Grilled-Cheese-Engineering/micro-keyer/complete 1.jpg

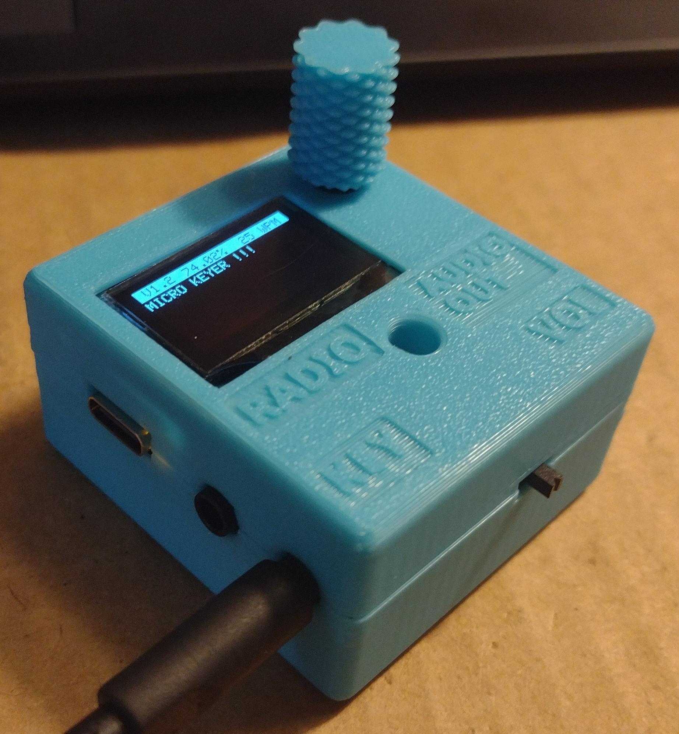
complete 1.jpg
