Grilled-Cheese-Engineering/micro-keyer/complete 2.jpg

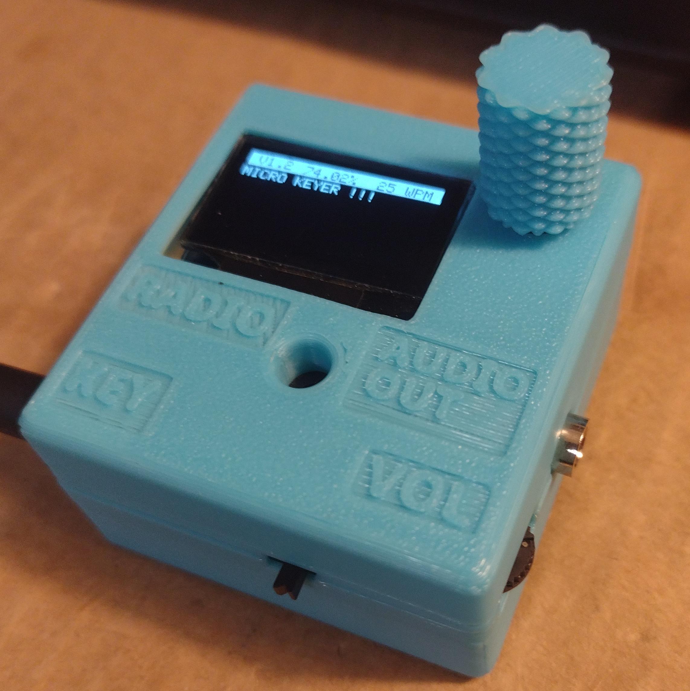
complete 2.jpg
