Grilled-Cheese-Engineering/micro-keyer/images/2026-10-27-21-33-01-062.jpg

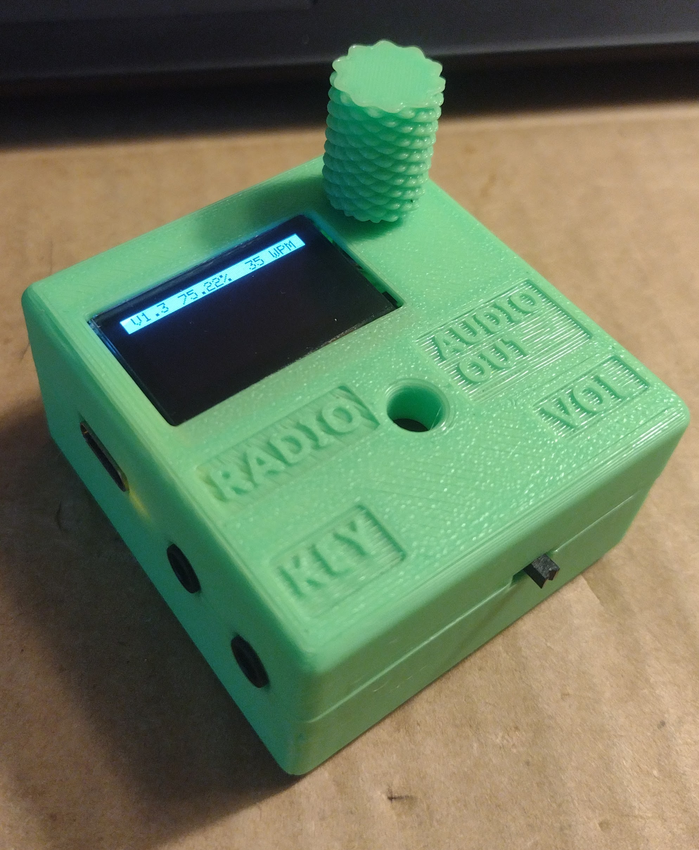
images/2026-10-27-21-33-01-062.jpg
