Grilled-Cheese-Engineering/micro-keyer/images/Screenshot_20261027_212848.png

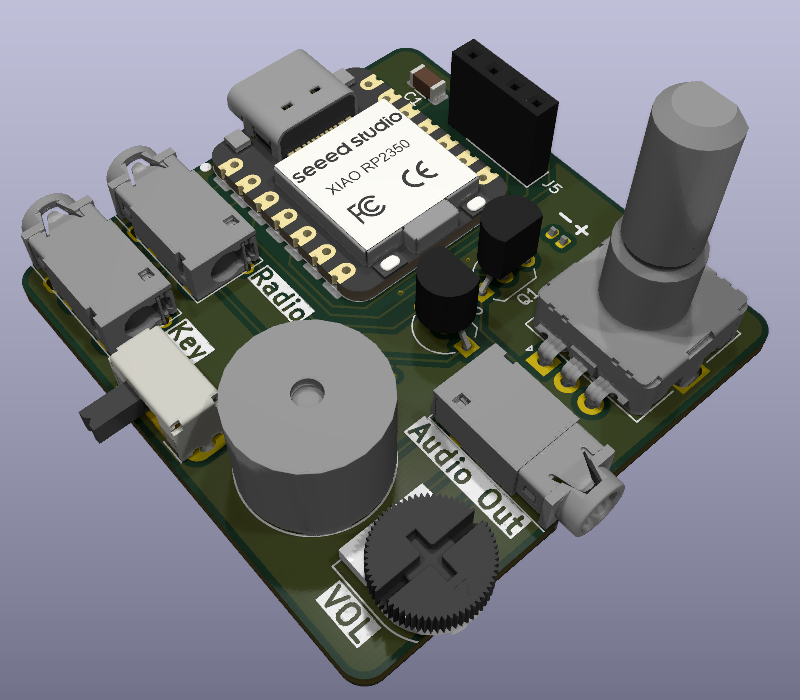
images/Screenshot_20261027_212848.png
