Grilled-Cheese-Engineering/micro-keyer/Screenshot_20260815_023649.png

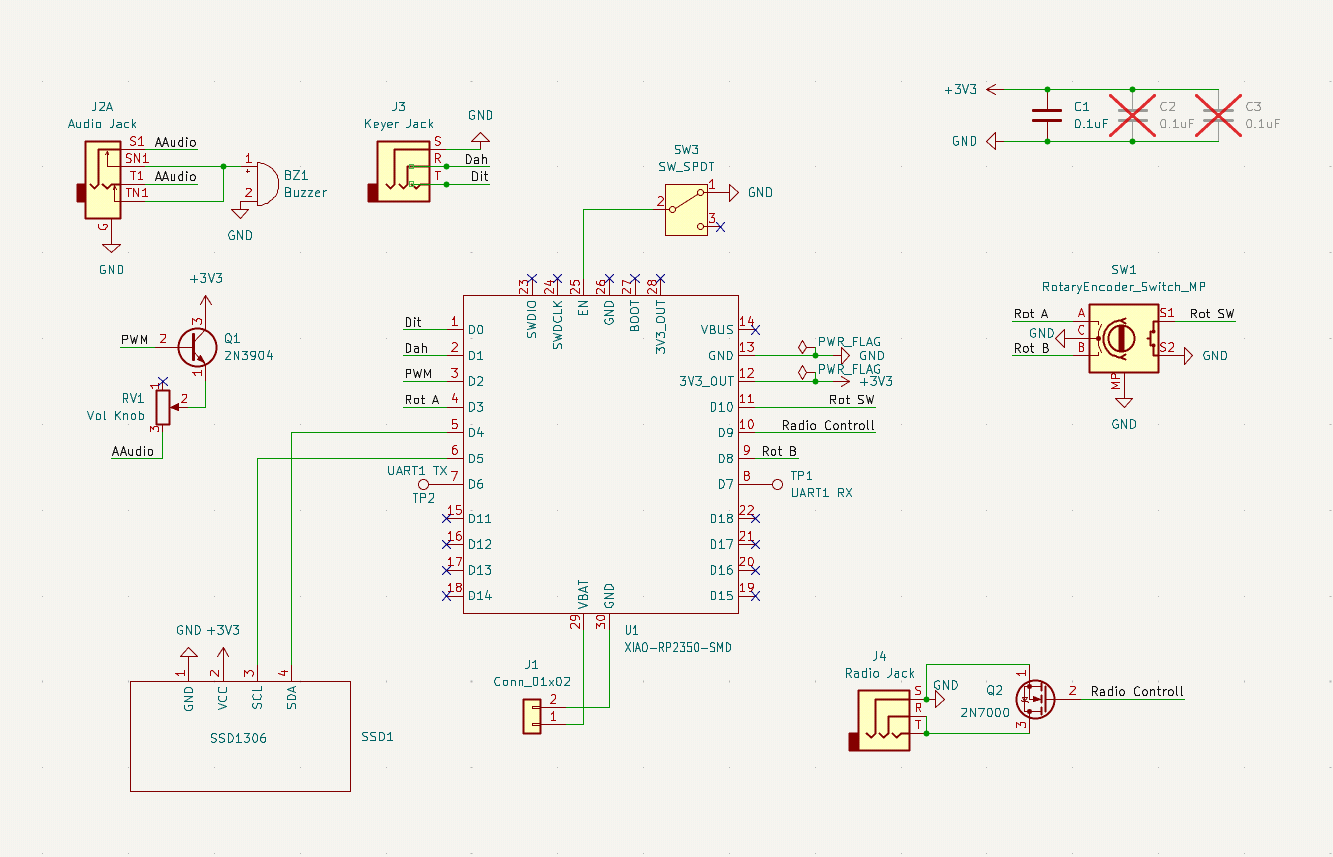
Screenshot_20260815_023649.png
