Grilled-Cheese-Engineering/micro-keyer/Screenshot_20260815_023707.png

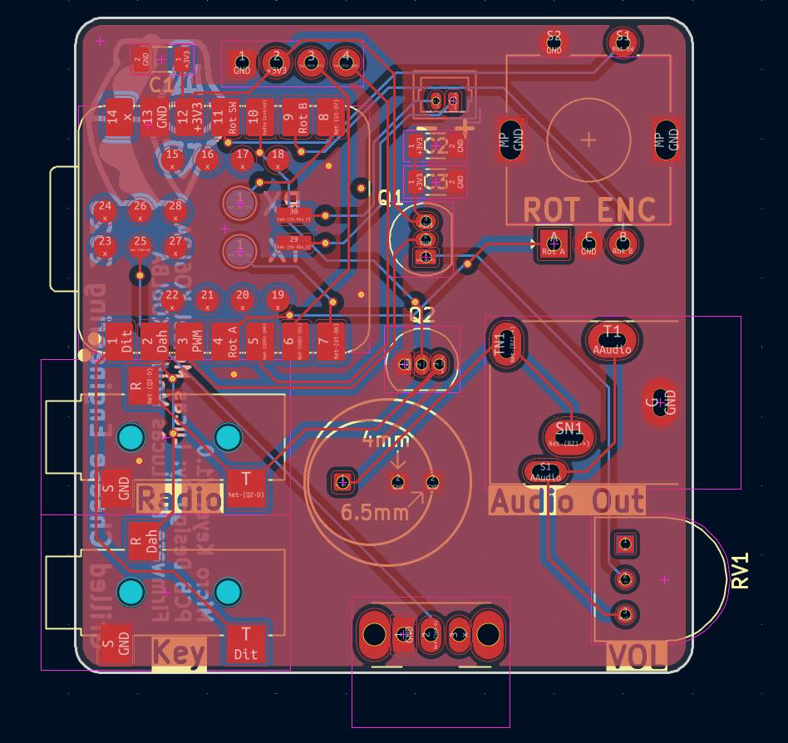
Screenshot_20260815_023707.png
