Grilled-Cheese-Engineering/micro-keyer/Screenshot_20260815_023733.png

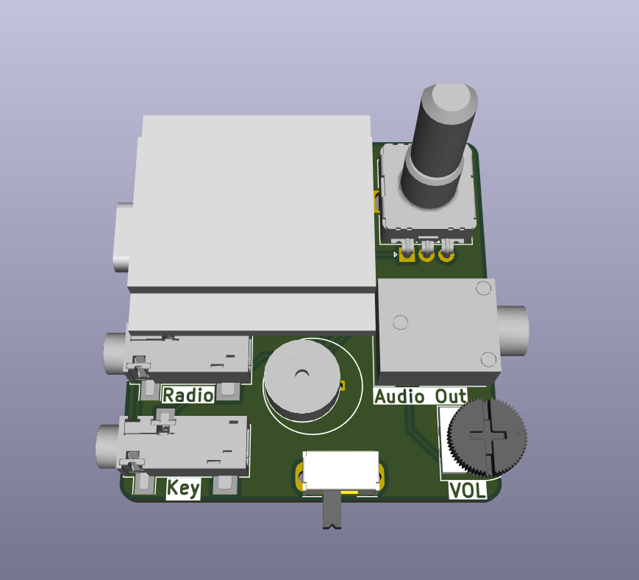
Screenshot_20260815_023733.png
