Grilled-Cheese-Engineering/micro-keyer/Screenshot_20260815_023755.png

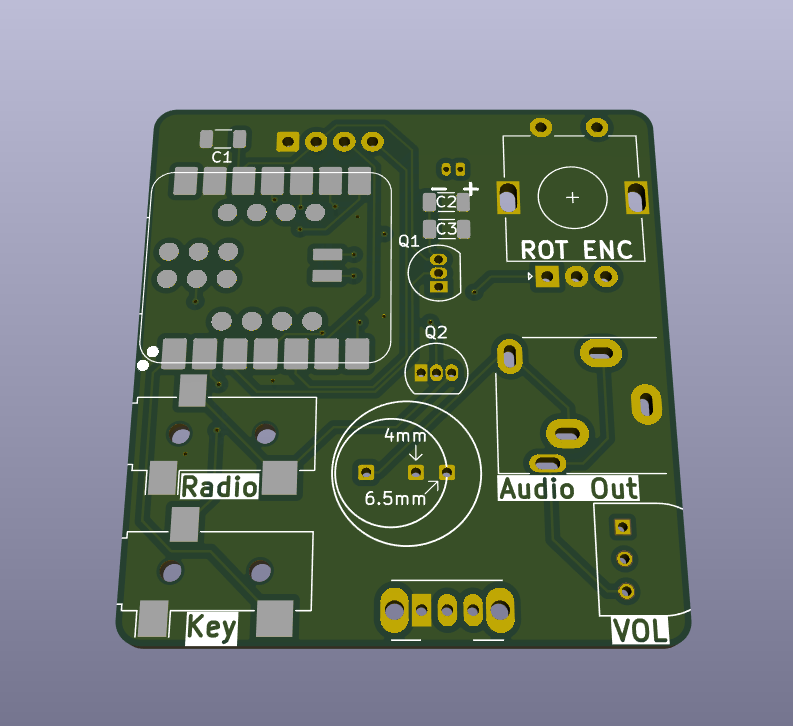
Screenshot_20260815_023755.png
