Grilled-Cheese-Engineering/micro-keyer/Screenshot_20260815_023818.png

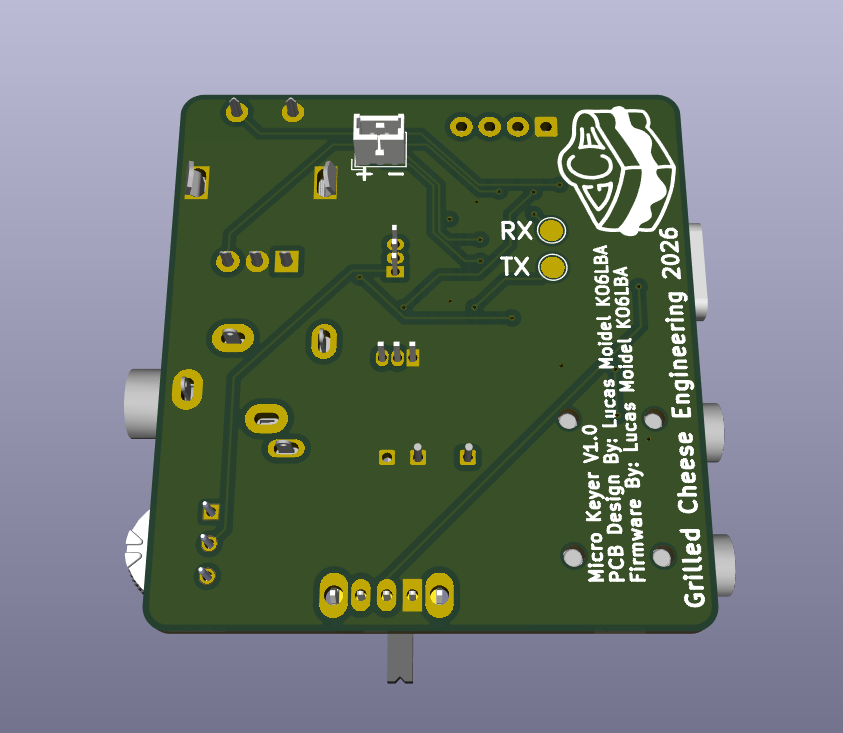
Screenshot_20260815_023818.png
