Grilled-Cheese-Engineering/micro-keyer/Screenshot_20260815_023836.png

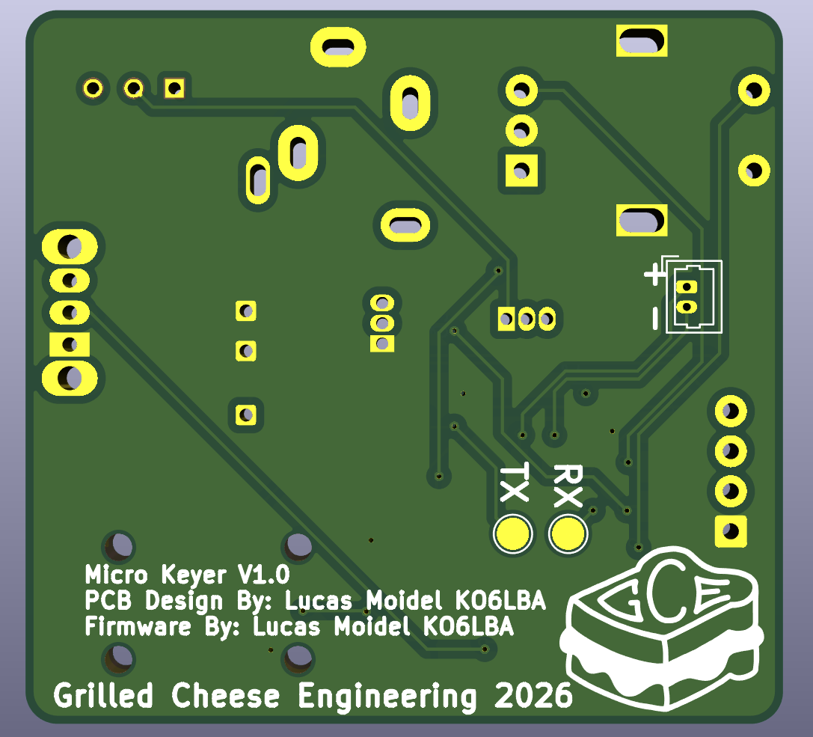
Screenshot_20260815_023836.png
