Grilled-Cheese-Engineering/micro-keyer/Screenshot_20260815_023911.png

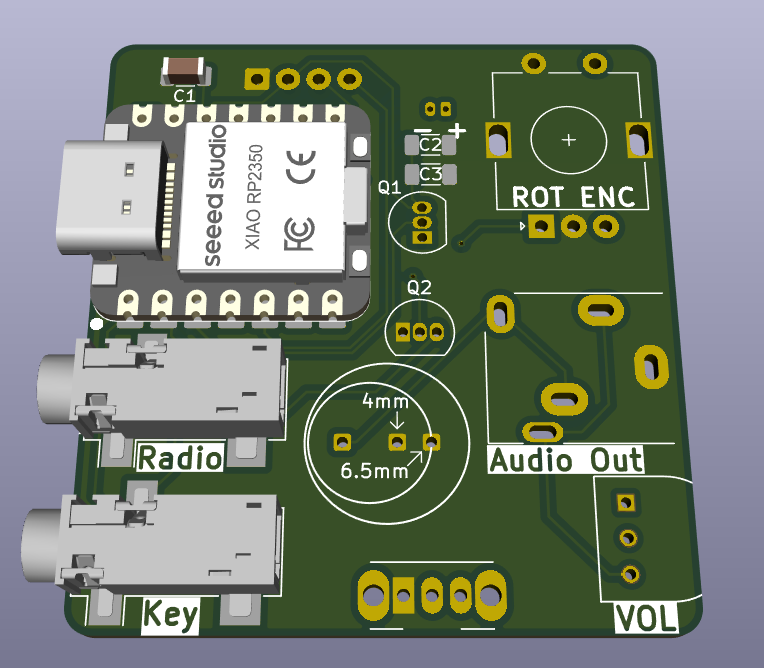
Screenshot_20260815_023911.png
