Grilled-Cheese-Engineering/micro-keyer/Screenshot_20260907_182525.png

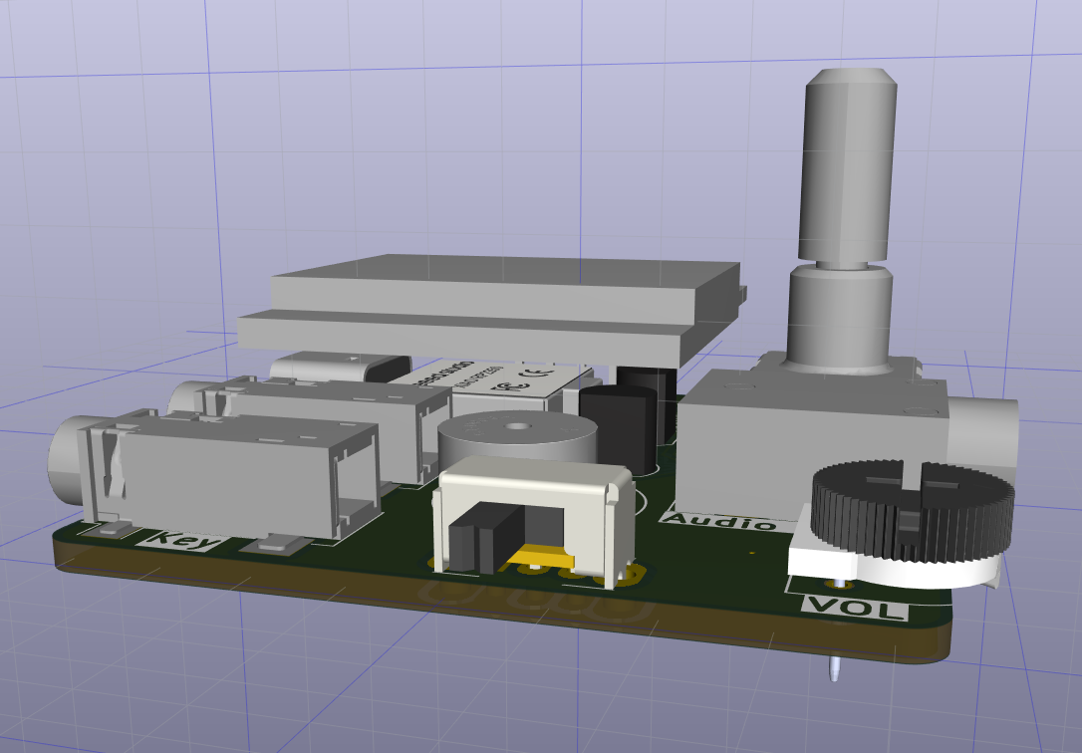
Screenshot_20260907_182525.png
