Grilled-Cheese-Engineering/micro-keyer/pcb/production/bom.csv

Designator | Footprint | Quantity | Value | LCSC Part #
BZ1 | buzzer_P4mm_9mm | 1 | Buzzer
C1 | 1206 | 1 | 0.1uF
J1 | Molex_PicoBlade_53047-0210_1x02_P1.25mm_Vertical | 1 | Conn_01x02
J2, J3, J4 | 54-00299 | 3 | Audio Jack
J5 | PinSocket_1x04_P2.54mm_Vertical | 1 | Conn_01x04_Socket
Q1 | TO-92_Inline_Wide | 1 | 2N3904
Q2 | TO-92_Inline_Wide | 1 | 2N7000
RV1 | TRIM_3352T-1-103LF | 1 | Vol Knob
SW1 | RotaryEncoder_Alps_EC11E-Switch_Vertical_H20mm | 1 | RotaryEncoder_Switch_MP
SW3 | SW_Slide_SPDT_Angled_CK_OS102011MA1Q | 1 | SW_SPDT
TP1 | TestPoint_Pad_D2.0mm | 1 | UART1 RX
TP2 | TestPoint_Pad_D2.0mm | 1 | UART1 TX
U1 | XIAO-RP2350-SMD-MODEL | 1 | XIAO-RP2350-SMD
