Grilled-Cheese-Engineering/micro-keyer/case.3mf

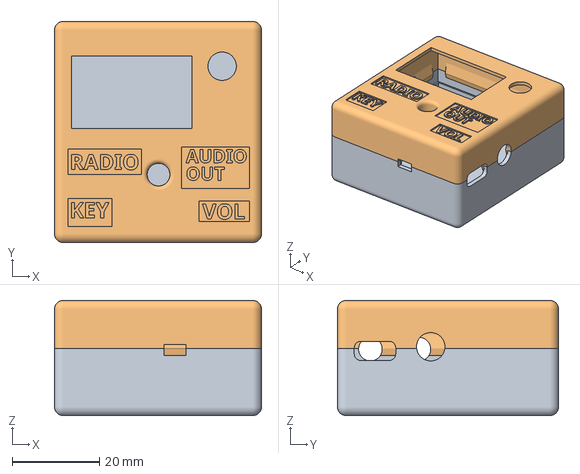
[picture p22: CAD file, 2026-11-06]
case.3mf
47.4 x 50.6 x 26.4 mm
