Grilled-Cheese-Engineering/micro-keyer/pcb/54-00174.STEP

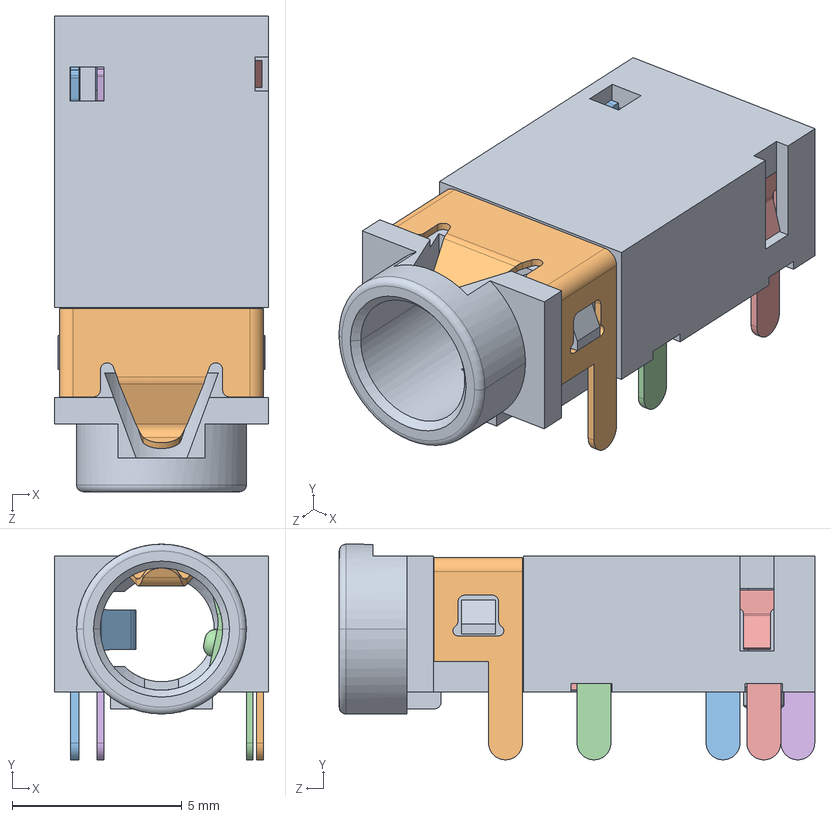
[picture p23: CAD file, 2026-10-26]
pcb/54-00174.STEP
6.30 x 6.35 x 14.0 mm
