Grilled-Cheese-Engineering/micro-keyer/knob.3mf

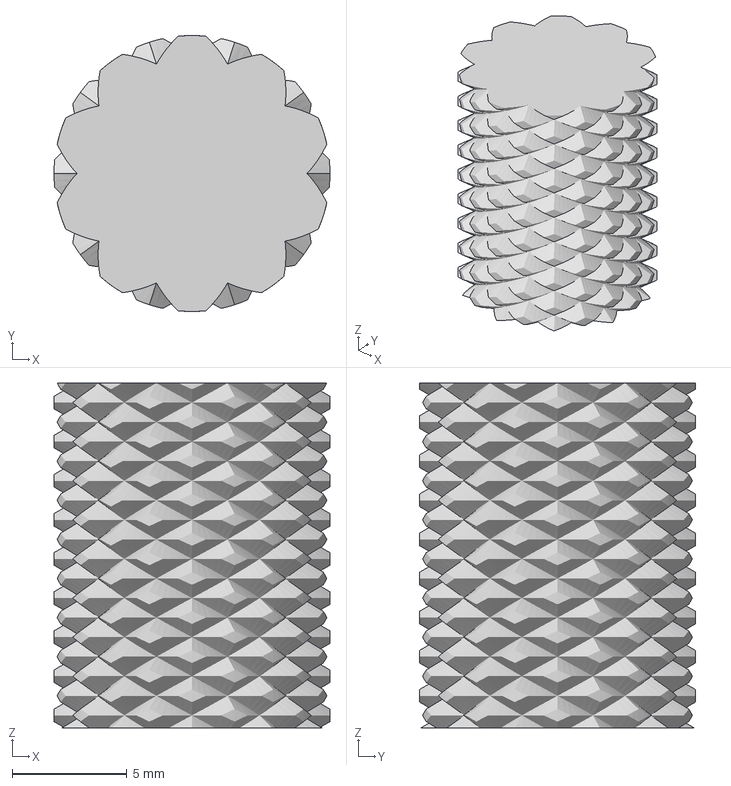
[picture p24: CAD file, 2026-09-29]
knob.3mf
12.0 x 12.0 x 15.0 mm
