Grilled-Cheese-Engineering/micro-keyer/pcb/WT-1205.step

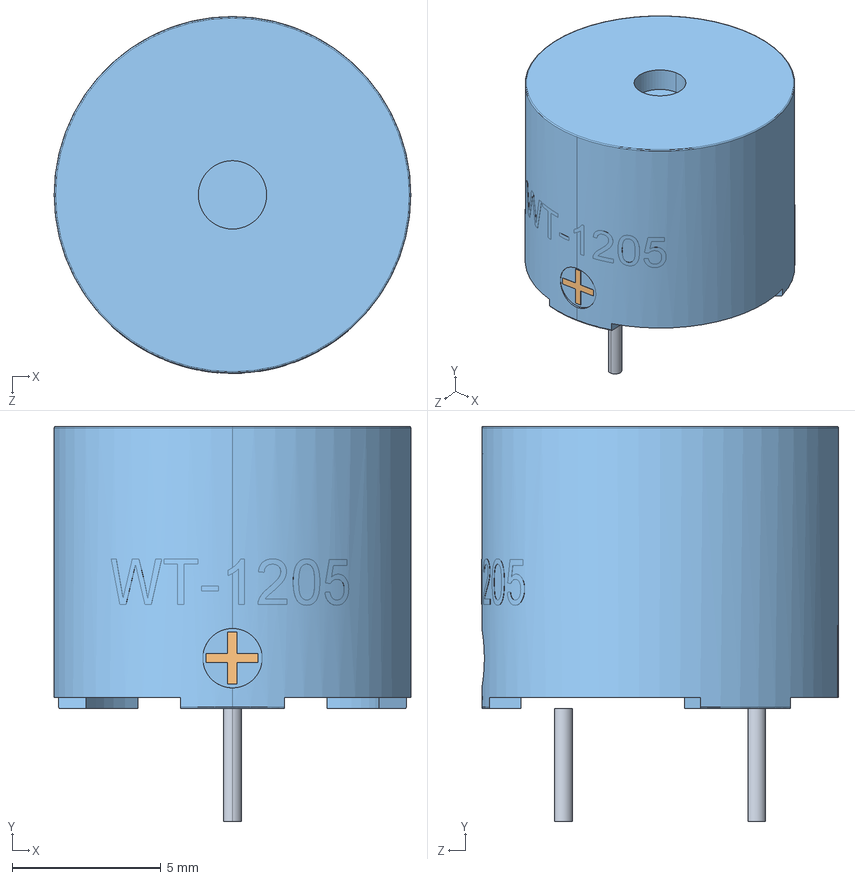
[picture p25: CAD file, 2026-10-26]
pcb/WT-1205.step
12.0 x 13.3 x 12.0 mm
