Grilled-Cheese-Engineering/micro-keyer/pcb/GT-0903A.step

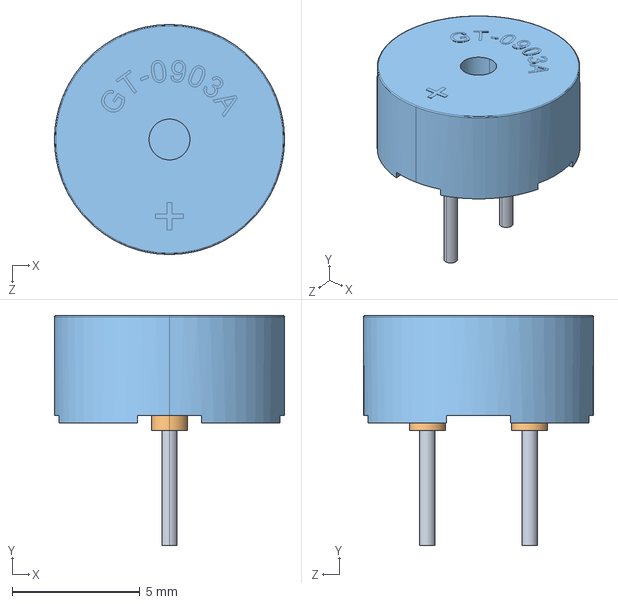
[picture p26: CAD file, 2026-08-10]
pcb/GT-0903A.step
9.00 x 9.01 x 9.00 mm
