Grilled-Cheese-Engineering/micro-keyer/pcb/PPPC041LFBN-RC.STEP

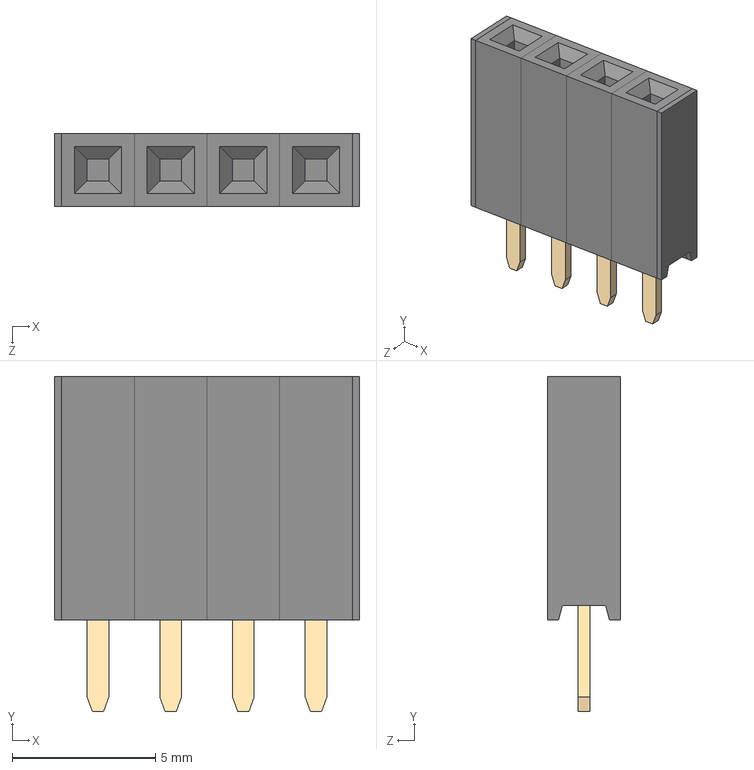
[picture p27: CAD file, 2026-08-10]
pcb/PPPC041LFBN-RC.STEP
10.7 x 11.7 x 2.54 mm
PPPC021LFBN-RC_C04
Pin - Gold x 4
