Grilled-Cheese-Engineering/micro-keyer/pcb/3352T-1-103LF.step

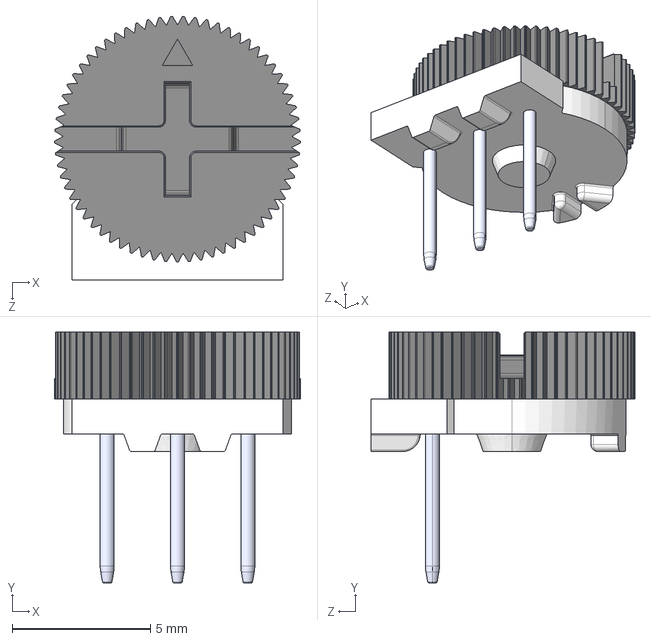
[picture p28: CAD file, 2026-08-09]
pcb/3352T-1-103LF.step
8.89 x 9.07 x 9.52 mm
