Grilled-Cheese-Engineering/micro-keyer/pcb/ec11e18244au.step

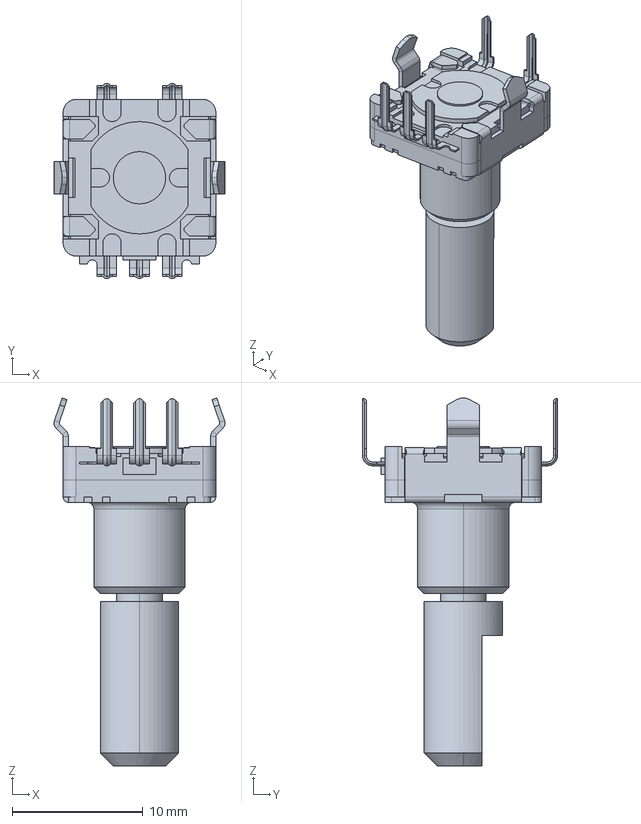
[picture p29: CAD file, 2026-08-09]
pcb/ec11e18244au.step
13.1 x 15.0 x 28.2 mm
