Grilled-Cheese-Engineering/micro-keyer/pcb/Same_Sky_SJ1-3535NG.step

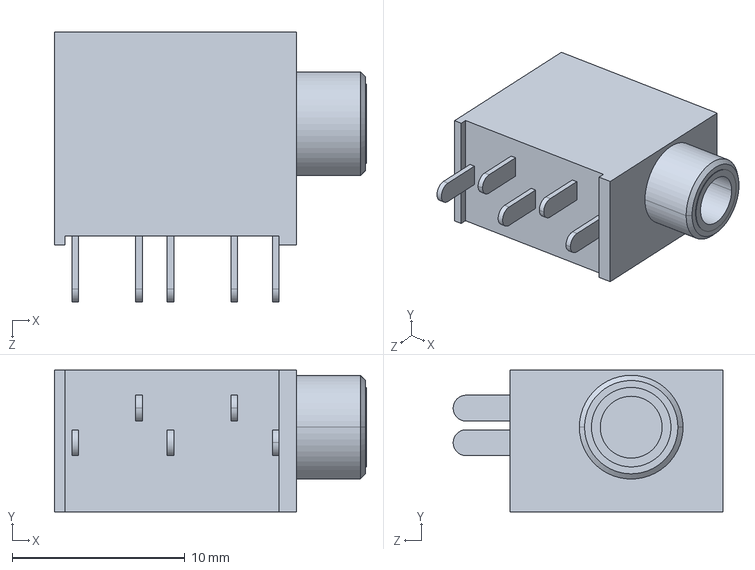
[picture p30: CAD file, 2026-08-09]
pcb/Same_Sky_SJ1-3535NG.step
18.1 x 8.20 x 15.6 mm
