Grilled-Cheese-Engineering/micro-keyer/pcb/Same_Sky_SJ-3523-SMT-TR.step

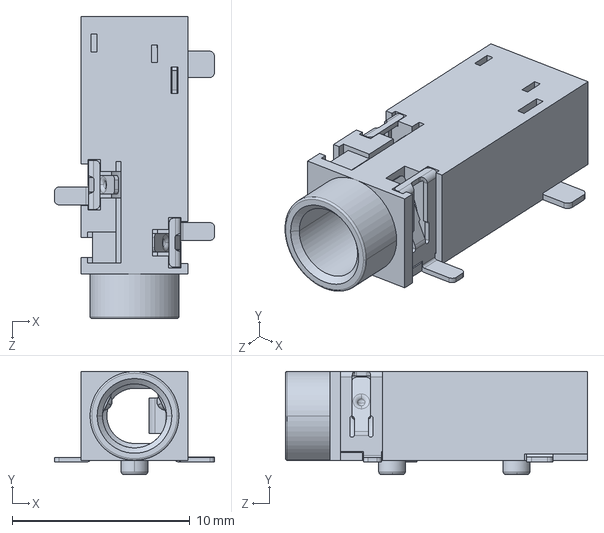
[picture p31: CAD file, 2026-08-09]
pcb/Same_Sky_SJ-3523-SMT-TR.step
9.00 x 5.80 x 17.0 mm
