Grilled-Cheese-Engineering/micro-keyer/pcb/rk09l1140a2u.step

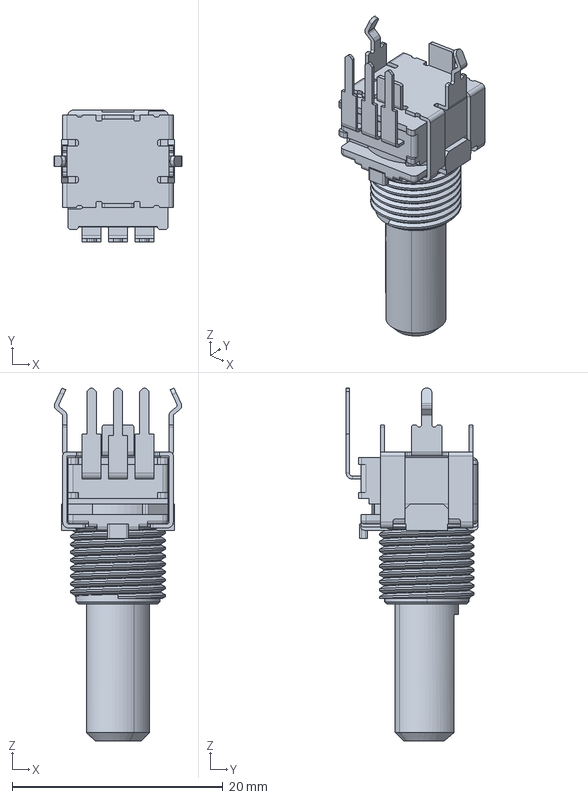
[picture p32: CAD file, 2026-08-09]
pcb/rk09l1140a2u.step
12.1 x 12.5 x 33.5 mm
