Grilled-Cheese-Engineering/micro-keyer/pcb/Same_Sky_SJ1-3515N.step

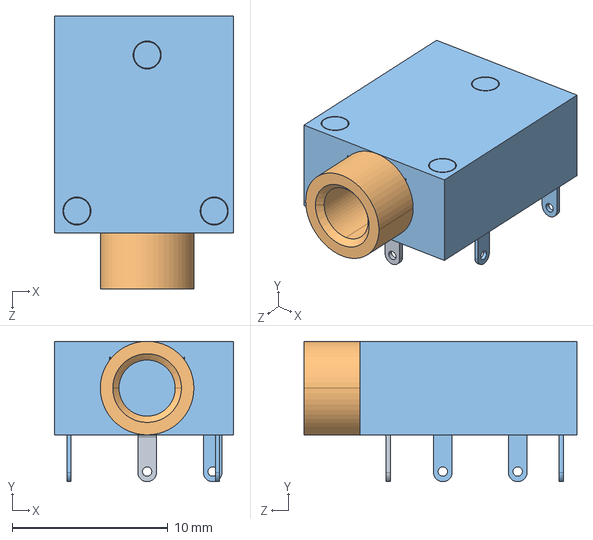
[picture p34: CAD file, 2026-08-08]
pcb/Same_Sky_SJ1-3515N.step
11.5 x 9.00 x 17.5 mm
