Grilled-Cheese-Engineering/micro-keyer/pcb/ssd1306.step

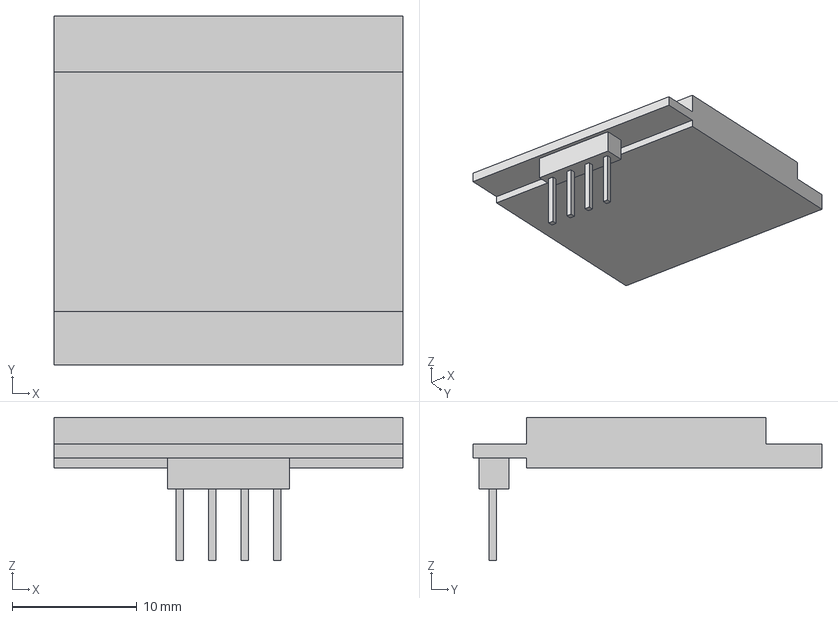
[picture p35: CAD file, 2026-08-08]
pcb/ssd1306.step
28.0 x 28.0 x 11.5 mm
