Grilled-Cheese-Engineering/micro-keyer/pcb/RK09K1110-K20.STEP

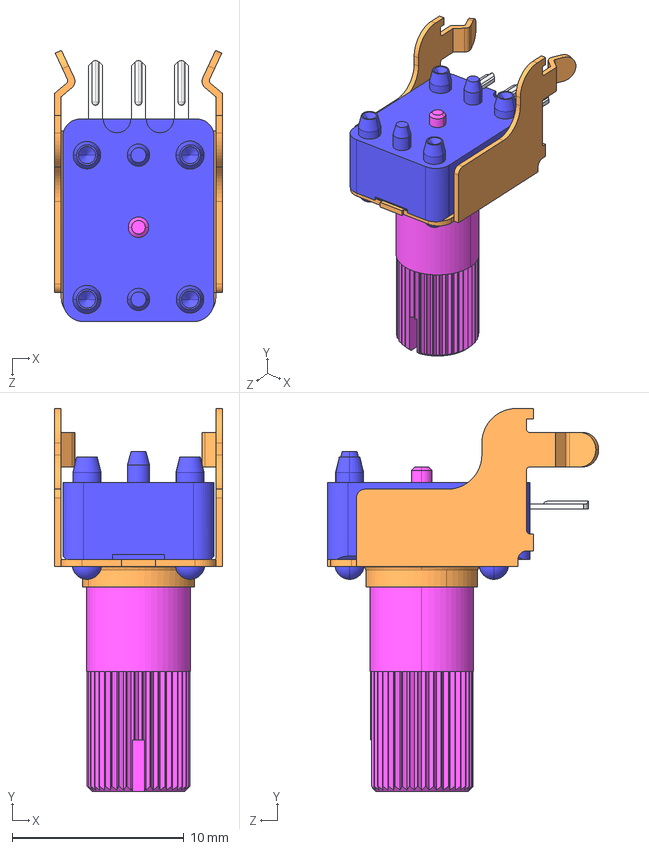
[picture p36: CAD file, 2026-08-08]
pcb/RK09K1110-K20.STEP
9.80 x 22.3 x 15.8 mm
