Grilled-Cheese-Engineering/micro-keyer/pcb/JST connector 1x2 P1.25mm thru hole wafer A2.step

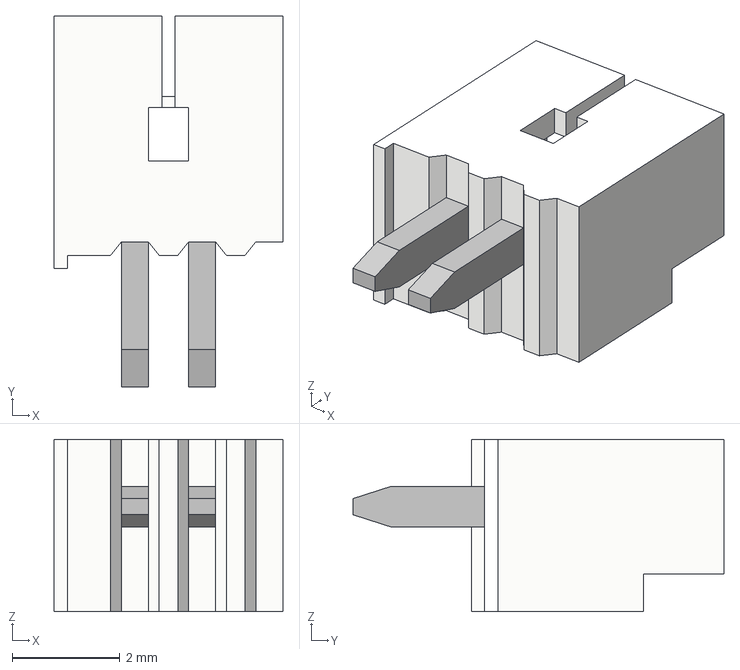
[picture p37: CAD file, 2026-08-08]
pcb/JST connector 1x2 P1.25mm thru hole wafer A2.step
4.25 x 6.90 x 3.20 mm
