Grilled-Cheese-Engineering/micro-keyer/pcb/SK-13D08-G-5-E.step

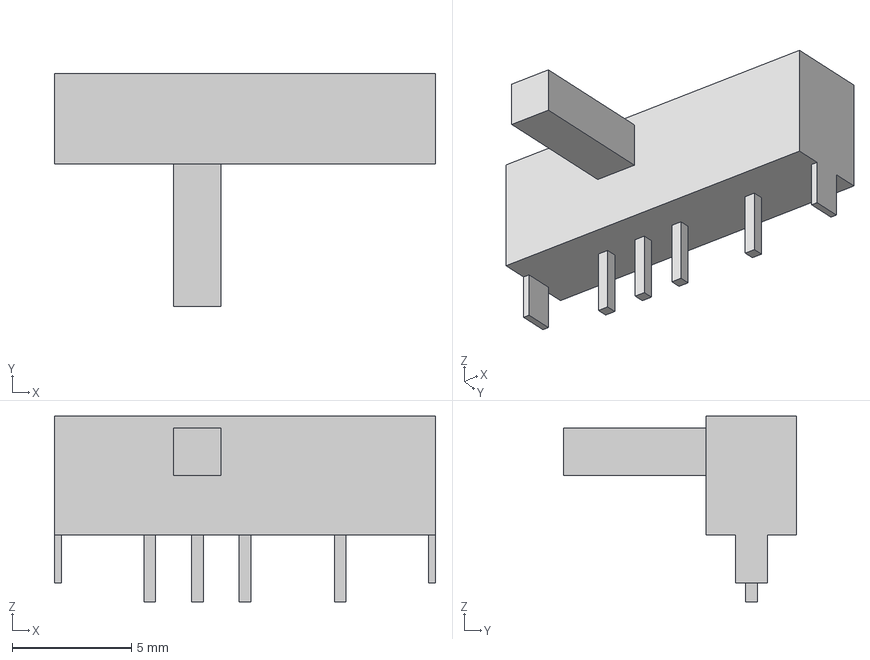
[picture p38: CAD file, 2026-08-08]
pcb/SK-13D08-G-5-E.step
16.0 x 9.80 x 7.80 mm
