Grilled-Cheese-Engineering/micro-keyer/(list of files, cad)

Other CAD files:
case.f3d
