Grilled-Cheese-Engineering/micro-keyer/pcb/micro-keyer.pdf

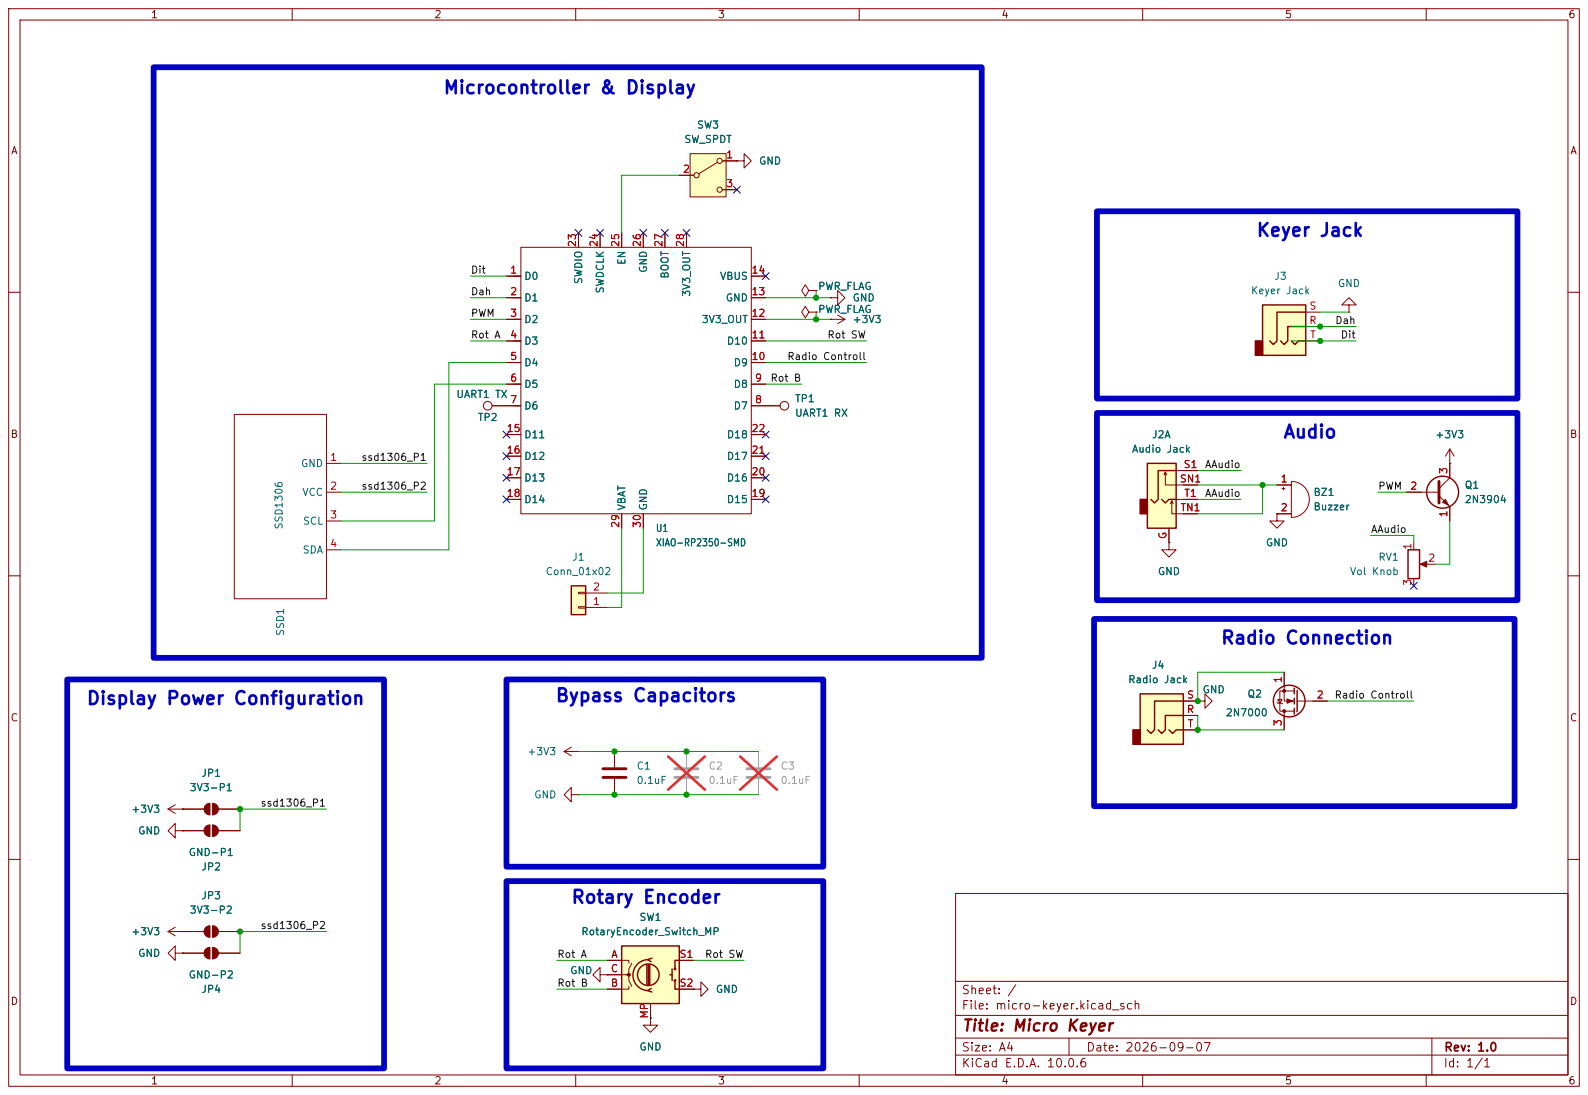
[picture p40: page 1]

Dah Rot SW Rotary Encoder

Size: A4 | Rev: 1.0
KiCad E.D.A. 10.0.6 | Id: 1/1
