Grilled-Cheese-Engineering/micro-keyer/display.h

#pragma once

#ifndef MENU_OPTION_H
#define MENU_OPTION_H
extern "C" {
    #include "ssd1306.h"
    #include "font.h"
}
#include "hardware/watchdog.h"
#include <string>
#include <vector>
#include <functional>
#include "hardware/flash.h"
#include "hardware/sync.h"
#include "git_version.h"
#include "chars.h"



extern ssd1306_t disp;

extern int speed;
extern int tone;
extern int mute;
extern bool USBMode[3];
extern int keyerMode;
extern bool reverse;
extern bool dumbMIDI;

extern int selected_item;
extern int clicked_item;

void keyer();

extern float minDit;
extern float ditDahThreshold;
extern float maxDah;

extern int nextdraw;

extern std::string decode;

void setSpeed(int x, bool reset = true);
void setTone(int x, bool reset = true);
void setKeyerMode(int x, bool reset = true);

void drawMain();
void drawMenu();
void drawFlashMode();
void drawInfo();
void reset(bool screen);
void loadSettings();
void saveSettings(bool reset = true);
void print(std::string str);


#define MODE_CDC_SERIAL  0
#define MODE_HID 1
#define MODE_MIDI 2

#define FLASH_TARGET_OFFSET (2 * 1024 * 1024 - FLASH_SECTOR_SIZE)
typedef struct __attribute__((aligned(FLASH_PAGE_SIZE))) {
    int speed;
    int tone;
    int mute;
    int keyerMode;
    bool USBMode[3];
    bool dumbMIDI;
    bool reverse;
} settings;

extern settings options;

class MenuOption {
public:

    MenuOption(std::string nameStr, std::string f, int val, int defaultVal, int maxVal, int minVal, std::function<void(MenuOption&)> inc, std::function<void(MenuOption&)> dec, std::function<void(MenuOption&)> app, std::function<void(MenuOption&)> load) :
        name(nameStr), format(f), value(val), incVal(inc), defaultvalue(defaultVal), decVal(dec), appVal(app), loadVal(load), maxValue(maxVal), minValue(minVal) {
    }

    MenuOption(std::string nameStr, std::vector<std::string> strArr, int val, int defaultVal, std::function<void(MenuOption&)> inc, std::function<void(MenuOption&)> dec, std::function<void(MenuOption&)> app, std::function<void(MenuOption&)> load) :
        name(nameStr), arr(strArr), defaultvalue(defaultVal), incVal(inc), decVal(dec), appVal(app), loadVal(load), useValueIndex(true) {
        if (val >= 0 && val < arr.size()) {
            valueIndex = val;
        }
    }

    MenuOption(std::string nameStr, int val, int defaultVal, std::function<void(MenuOption&)> act, std::function<void(MenuOption&)> load) :
        name(nameStr), value(val), defaultvalue(defaultVal), action(act), loadVal(load), useBool(true) {

    }

    MenuOption(std::string nameStr, std::function<void(MenuOption&)> act) :
        name(nameStr), action(act), useAction(true) {
    }

    std::string name = "Option";
    std::string format = "{}";
    bool useValueIndex = false;
    bool useBool = false;
    bool useAction = false;
    uint32_t valueIndex = 0;
    std::vector<std::string> arr;
    int value;
    int defaultvalue;
    int maxValue;
    int minValue = 0;
    std::function<void(MenuOption&)> incVal = [](MenuOption& self) {};
    std::function<void(MenuOption&)> decVal = [](MenuOption& self) {};
    std::function<void(MenuOption&)> appVal = [](MenuOption& self) {};
    std::function<void(MenuOption&)> loadVal = [](MenuOption& self) {};
    std::function<void(MenuOption&)> action = [](MenuOption& self) {};
    void turnL() {
        decVal(*this);
    }
    void turnR() {
        incVal(*this);
    }
    void click() {
        appVal(*this);
    }
    void load() {
        loadVal(*this);
    }
    void select() {
        action(*this);
    }
    void reset() {
        if (!useAction && !useBool && !useValueIndex) {
            if (value != defaultvalue) {
                value = defaultvalue;
                if (useAction) {
                    select();
                } else {
                    click();
                }
            }
        } else if (useValueIndex) {
            if (valueIndex != defaultvalue) {
                valueIndex = defaultvalue;
                if (useAction) {
                    select();
                } else {
                    click();
                }
            }
        } else if (useBool) {
            if (value != defaultvalue) {
                value = defaultvalue;
                if (useAction) {
                    select();
                } else {
                    click();
                }
            }
        }
    }
};


extern std::vector<MenuOption> optionList;

#endif
