Grilled-Cheese-Engineering/micro-keyer/(commit log)

2026-08-08 MORE PCB
2026-08-09 MOOOOORE PCB
    [Same_Sky_SJ-3523-SMT-TR.step, Same_Sky_SJ1-3533NG.step, Same_Sky_SJ1-3535NG.step, micro-keyer.kicad_pcb, micro-keyer.kicad_sch, rk09l1140a2u.step]
2026-08-09 rotary encoder
    [micro-keyer.kicad_pcb, micro-keyer.kicad_sch]
2026-08-09 pull test
    [micro-keyer.kicad_sch]
2026-08-10 almost done PCB
    [GT-0903A.step, PPPC041LFBN-RC.STEP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]
2026-08-14 almost done with flash
    [micro-keyer.kicad_pcb]
2026-08-18 pin ma[
2026-08-19 Update pin map formatting in README.md
2026-08-19 add images of pcb
2026-08-30 improve menu
    [bom.csv, designators.csv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]
2026-09-01 fix usb option save
    [micro-keyer.kicad_pcb, micro-keyer.kicad_sch]
2026-09-08 format schematic
    [micro-keyer.kicad_pcb, micro-keyer.kicad_sch]
2026-09-26 v1.1.2
    add computer keying and some serial stuff. Also update PCB layout a bit more.
    [micro-keyer.kicad_pcb, micro-keyer.kicad_sch]
2026-09-28 start winkeyer emulation
    [micro-keyer.kicad_pcb]
2026-09-29 improve computer keying and add case model files
    [case.3mf, knob.3mf]
2026-10-01 add Iambic A, straight key, and bug emulation.
    [bom.csv, positions.csv]
2026-10-02 improve check box menu and add decode for straight key and bug emulation
    [display.cpp, main.cpp]
2026-10-14 battery stuff
2026-10-14 improve ui and add boot button
2026-10-19 update pcb
2026-10-19 images and bom
2026-10-19 BOM viewer?
2026-10-19 add BOM viewer to readme
2026-10-20 Update .gitattributes to mark bom as vendored
2026-10-22 lowe case serial
2026-10-22 add clear button
2026-10-26 update case 3d model
2026-10-26 change 3.5mm jack and fix reverse
2026-10-27 reset button
2026-11-02 Document V1.1 Board features and enhancements
    Added information about V1.1 Board improvements to README.
